orsonmmz/kicon19-badge-hw/documentation/kicon19-badge.pdf

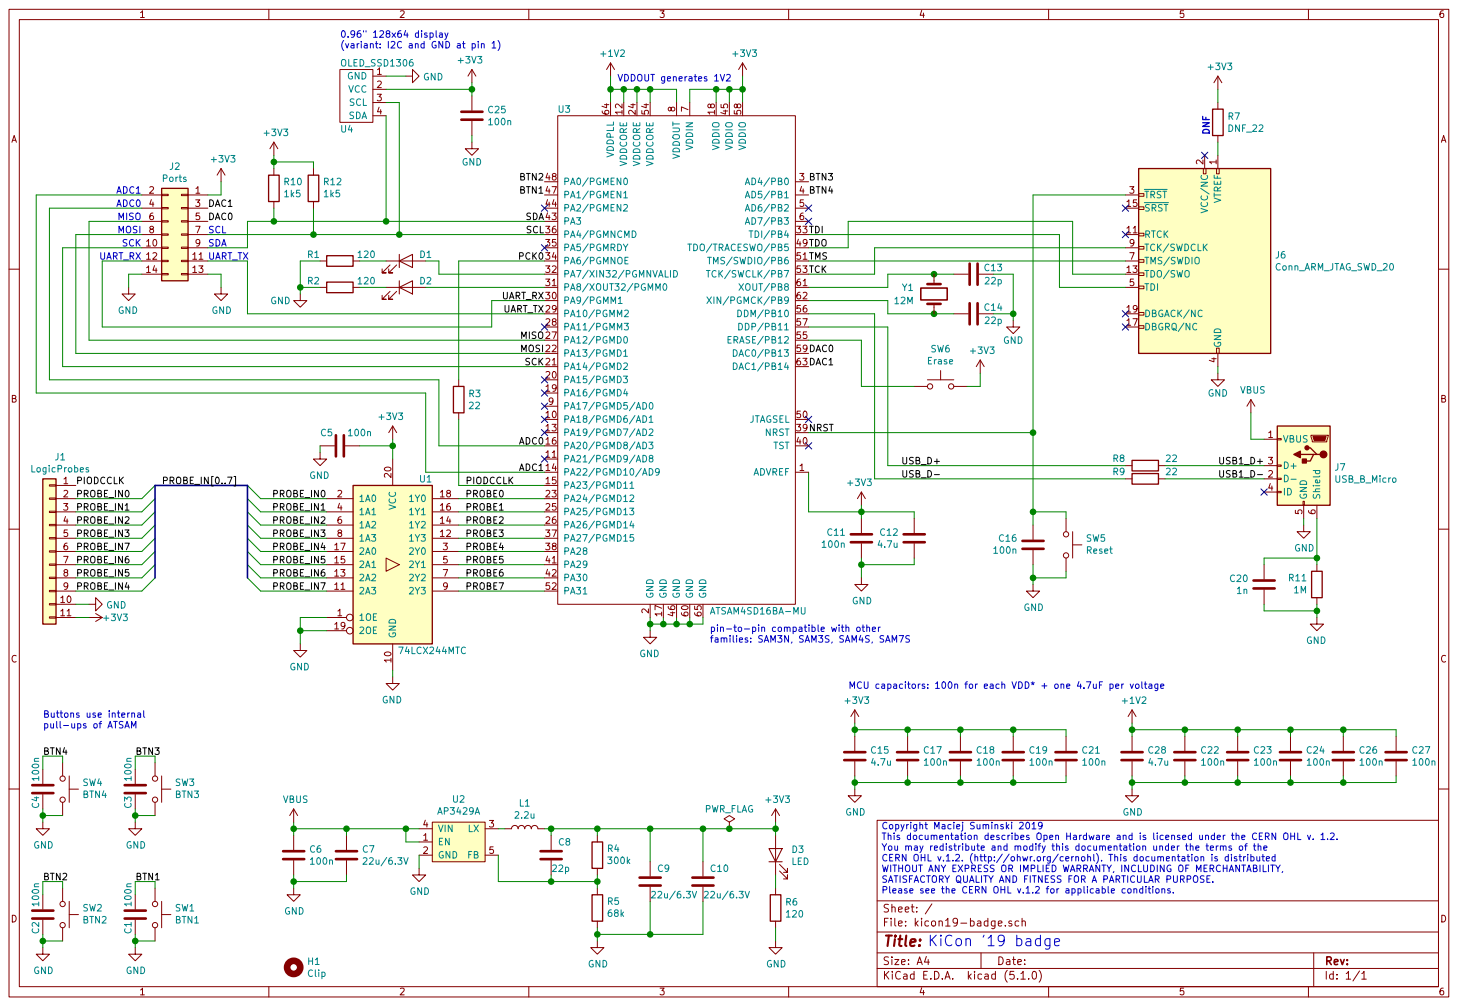
[picture p2: page 1]

2 PA15/PGMD3 20 PA14/PGMD2 21 PA13/PGMD1 22 PA24/PGMD12 23 VDDCORE 24 PA25/PGMD13 25 PA26/PGMD14 26 PA12/PGMD0 27 PA11/PGMM3 28 PA10/PGMM2 29 AD4/PB0 3 PA9/PGMM1 30 PA8/XOUT32/PGMM0 31 PA7/XIN32/PGMNVALID 32 TDI/PB4 33 PA6/PGMNOE 34 PA5/PGMRDY 35 PA4/PGMNCMD 36 PA27/PGMD15 37 PA28 38 NRST 39 AD5/PB1 4 TST 40 PA29 41 PA30 42 PA3 43 PA2/PGMEN2 44 VDDIO 45 GND 46 PA1/PGMEN1 47 PA0/PGMEN0 48 TDO/TRACESWO/PB5 49 AD6/PB2 5

1 RTCK 11 TDO/SWO 13 SRST 15 DBGRQ/NC 17 DBGACK/NC 19 VCC/NC

10 | | 9

4 TDI 5 TMS/SWDIO 7 TCK/SWDCLK 9

DAC0 DAC1 ADC0 ADC1 MISO MOSI SCK GND

+3V3 H1 Clip Buttons use internal pull-ups of ATSAM

pin-to-pin compatible with other
families: SAM3N, SAM3S, SAM4S, SAM7S

100n MCU capacitors: 100n for each VDD* + one 4.7uF per voltage SW2 BTN2 C2 100n BTN2 GND

This documentation describes Open Hardware and is licensed under the CERN OHL v. 1.2.
You may redistribute and modify this documentation under the terms of the
CERN OHL v.1.2. (http://ohwr.org/cernohl). This documentation is distributed WITHOUT ANY EXPRESS OR IMPLIED WARRANTY, INCLUDING OF MERCHANTABILITY, SATISFACTORY QUALITY AND FITNESS FOR A PARTICULAR PURPOSE. Please see the CERN OHL v.1.2 for applicable conditions.
