orsonmmz/kicon19-badge-hw/(commit log)

2019-01-10 Initial commit. WIP
    [kicon-badge2.kicad_pcb, kicon-badge2.sch]
2019-01-12 Added keep-out drawings around mounting holes in the OLED footprint
2019-01-12 Fixed LCD placement
    [kicon-badge2.kicad_pcb, kicon-badge2.sch]
2019-01-13 Fixed silkscreen and 3D models
    [kicon-badge2.kicad_pcb, kicon-badge2.sch]
2019-01-13 Added Digi-Key logo
    [kicon-badge2.kicad_pcb, kicon-badge2.sch]
2019-01-13 Fixed button footprints
    [kicon-badge2.kicad_pcb, kicon-badge2.sch]
2019-01-13 Added description on silkscreen
    [kicon-badge2.kicad_pcb]
2019-01-13 Added I2C pull-ups
    [kicon-badge2.kicad_pcb, kicon-badge2.sch]
2019-01-16 Restored and locked the Digi-Key logo
    [kicon-badge2.kicad_pcb]
2019-01-16 Updated the part numbers
    [kicon-badge2.kicad_pcb, kicon-badge2.sch]
2019-01-20 Mark R7 as not mounted
    [kicon-badge2.sch]
2019-01-20 Fix part number of the JTAG header
    [kicon-badge2.sch]
2019-02-06 Added Aisler and KiCon logos
    [kicon-badge2.kicad_pcb]
2019-02-06 Fixed the logic probes connector part number
    [kicon-badge2.sch]
2019-02-14 Final fixes
    [kicon-badge2.kicad_pcb, kicon-badge2.sch]
2019-02-16 Silkscreen adjustments
    [kicon-badge2.kicad_pcb, kicon-badge2.sch]
2019-02-20 Added footprints with larger logos
2019-02-20 Rounded corners
    [kicon-badge2.kicad_pcb]
2019-02-20 Larger lanyard hole, added '2019' text
    [kicon-badge2.kicad_pcb]
2019-03-05 Replaced the Digi-Key logo
    [kicon-badge2.kicad_pcb]
2019-04-19 Added license text
    [kicon-badge2.kicad_pcb, kicon-badge2.sch]
2019-04-19 Renamed files
    [kicon19-badge.kicad_pcb, kicon19-badge.sch]
2019-04-19 Documentation files
    [kicon19-badge-B_Cu.gbr, kicon19-badge-B_Mask.gbr, kicon19-badge-B_Paste.gbr, kicon19-badge-B_SilkS.gbr, kicon19-badge-Edge_Cuts.gbr, kicon19-badge-F_Cu.gbr, kicon19-badge-F_Mask.gbr, kicon19-badge-F_Paste.gbr]
